woodepic/Automotive-Control-Interface/PCB Design/matts pcb schematic v3.brd

## EAGLE design PCB Design/matts pcb schematic v3.brd (2022-01-21)

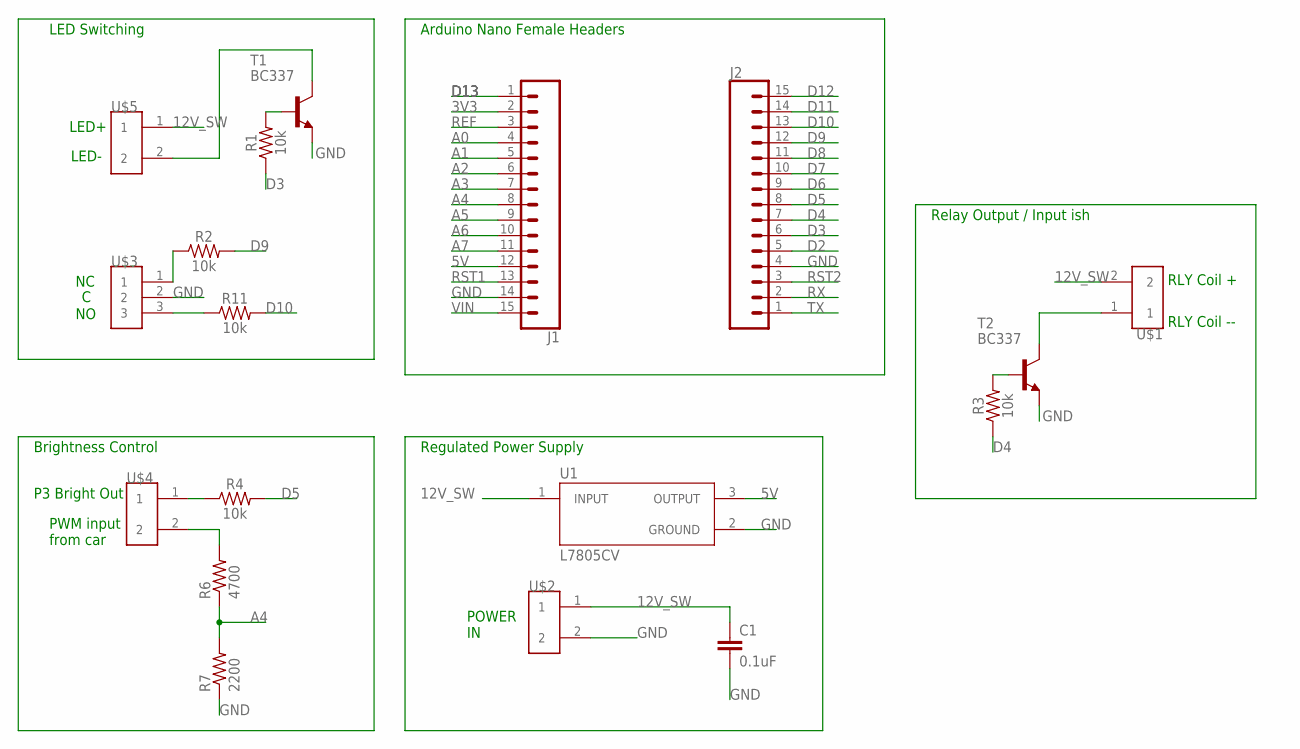
[picture p3: schematic matts pcb schematic v3.sch]

Parts:
C1: 0.1uF; CAP-PTH-SMALL-KIT
J1, J2: CONN_15; 1X15
R1, R2, R3, R4, R11: 10k; AXIAL-0.3
R6: 4700; 0207/10
R7: 2200; 0207/10
T1, T2: BC337; TO92
U1: L7805CV; TO255P1040X460X1968-3
U$1, U$2, U$4, U$5: 2PIN_0.2PITCH_SCREW_TERMINAL
U$3: 3PIN_0.2PITCH_SCREW_TERMINAL

Connections:
3V3: J1.2
5V: J1.12, U1.3 (OUTPUT)
12V_SW: C1.1, U1.1 (INPUT), U$1.2, U$2.1, U$5.1
A0: J1.4
A1: J1.5
A2: J1.6
A3: J1.7
A4: J1.8, R6.1, R7.2
A5: J1.9
A6: J1.10
A7: J1.11
D2: J2.5
D3: J2.6, R1.P$1 (1)
D4: J2.7, R3.P$1 (1)
D5: J2.8, R4.P$2 (2)
D6: J2.9
D7: J2.10
D8: J2.11
D9: J2.12, R2.P$2 (2)
D10: J2.13, R11.P$2 (2)
D11: J2.14
D12: J2.15
D13: J1.1
GND: C1.2, J1.14, J2.4, R7.1, T1.1 (E), T2.1 (E), U1.2 (GROUND), U$2.2, U$3.2
unnamed: R2.P$1 (1), U$3.1
unnamed: T2.3 (C), U$1.1
unnamed: R4.P$1 (1), U$4.1
unnamed: T1.3 (C), U$5.2
unnamed: R3.P$2 (2), T2.2 (B)
unnamed: R1.P$2 (2), T1.2 (B)
unnamed: R6.2, U$4.2
unnamed: R11.P$1 (1), U$3.3
REF: J1.3
RST1: J1.13
RST2: J2.3
RX: J2.2
TX: J2.1
VIN: J1.15

Notes on the sheet:
Arduino Nano Female Headers
LED+
LED-
Regulated Power Supply
LED Switching
Relay Output / Input ish
RLY Coil +
RLY Coil --
Brightness Control
P3 Bright Out
PWM input from car
POWER IN

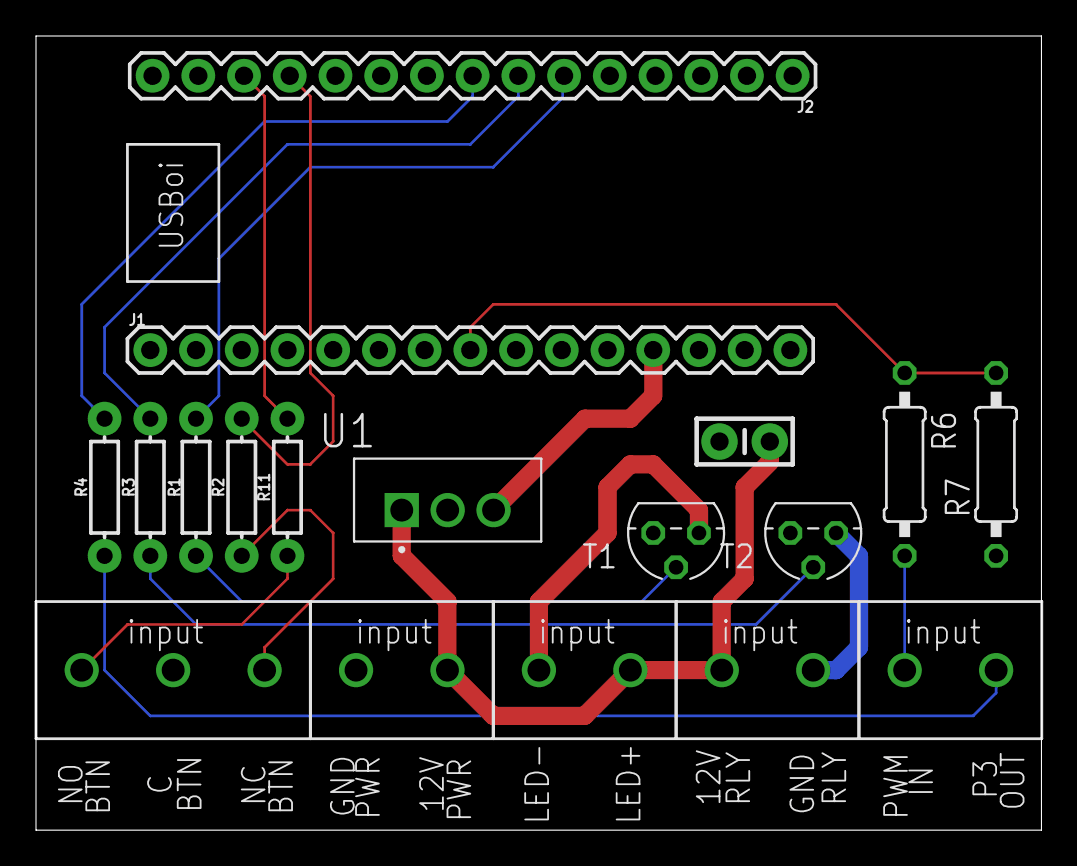
[picture p4: board matts pcb schematic v3.brd from above]

Board: 2 copper layers, 55.9 x 44.1 mm, 18 parts (0 on the bottom side), 17 nets.
