woodepic/Automotive-Control-Interface/(commit log)

2022-01-21 Eagle project files
    [matts pcb schematic v3.brd, matts pcb schematic v3.sch]
2022-01-21 Arduino Code
